L10N37/PSXTAL/PU22+/PU23_Install/PU23_PSXTAL_3F0.png

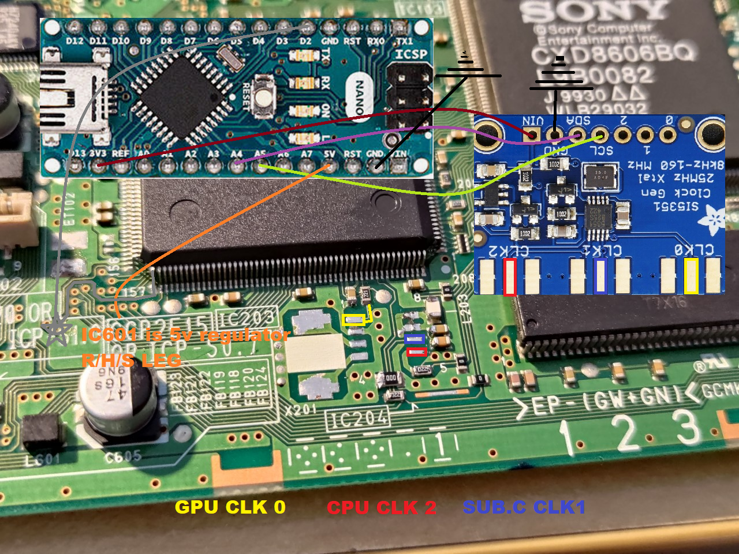
PU22+/PU23_Install/PU23_PSXTAL_3F0.png
