L10N37/PSXTAL/PSXTAL_IGR/ControllerRearWiring.webp

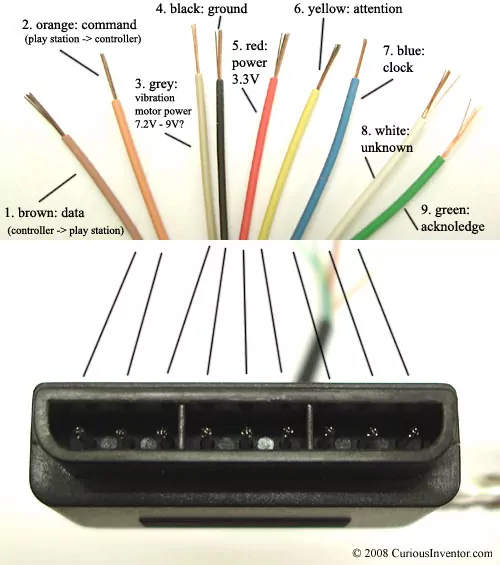
PSXTAL_IGR/ControllerRearWiring.webp
