L10N37/PSXTAL/PSXTAL-DFO/Flashing/FuseSettings.png

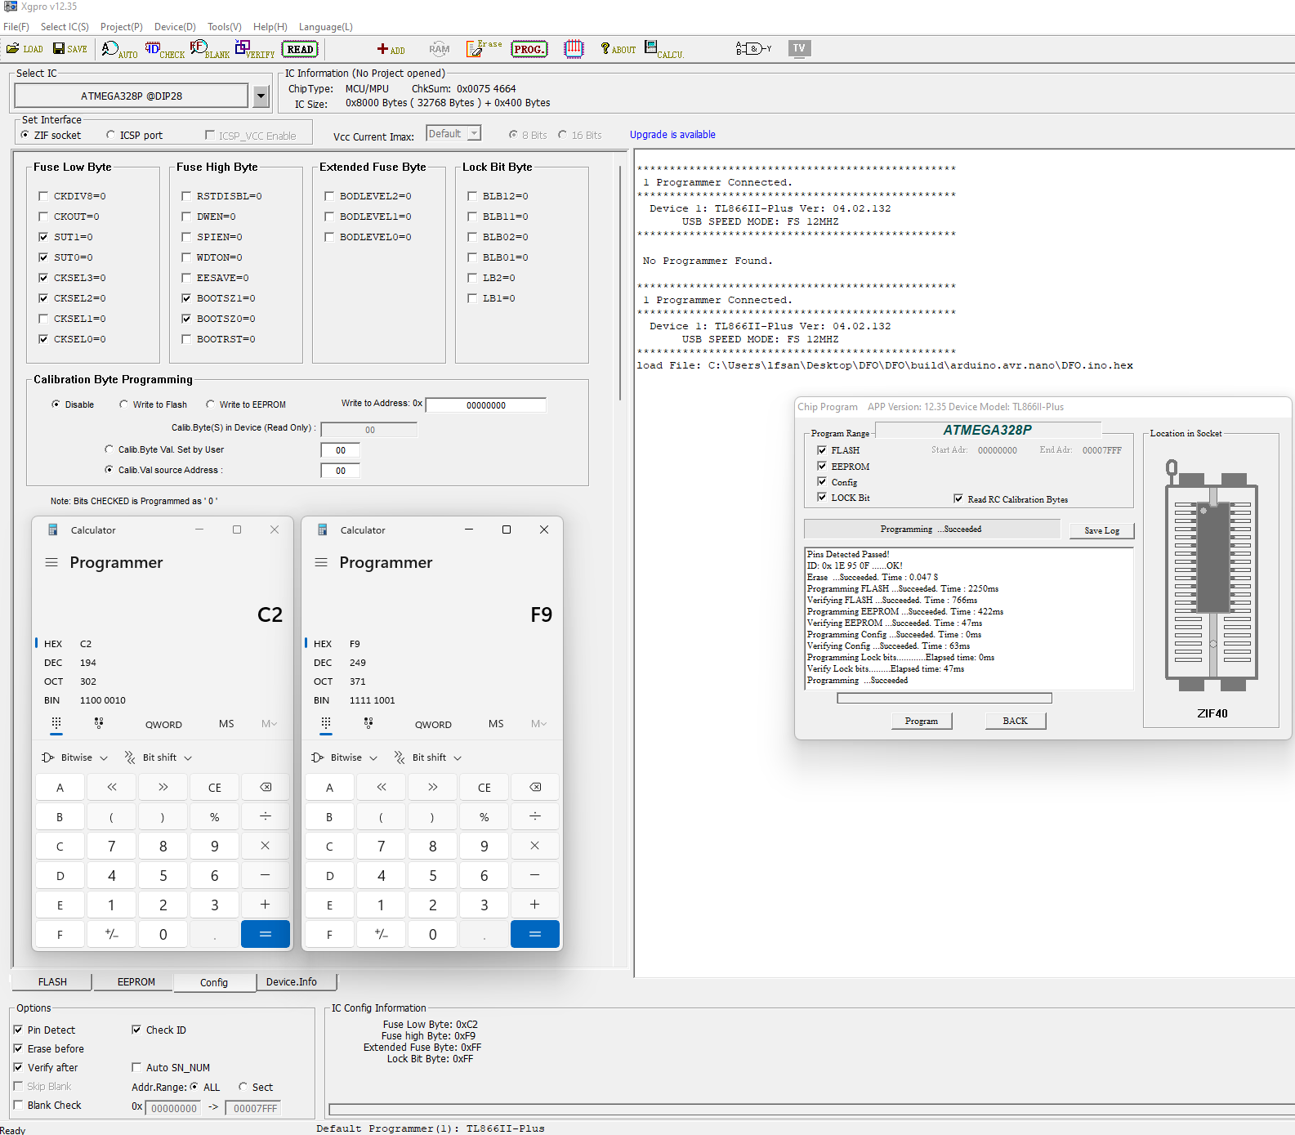
PSXTAL-DFO/Flashing/FuseSettings.png
