L10N37/PSXTAL/PSXTAL-DFO/Flashing/PinOuts-LGT8F-Atmega-328P.png

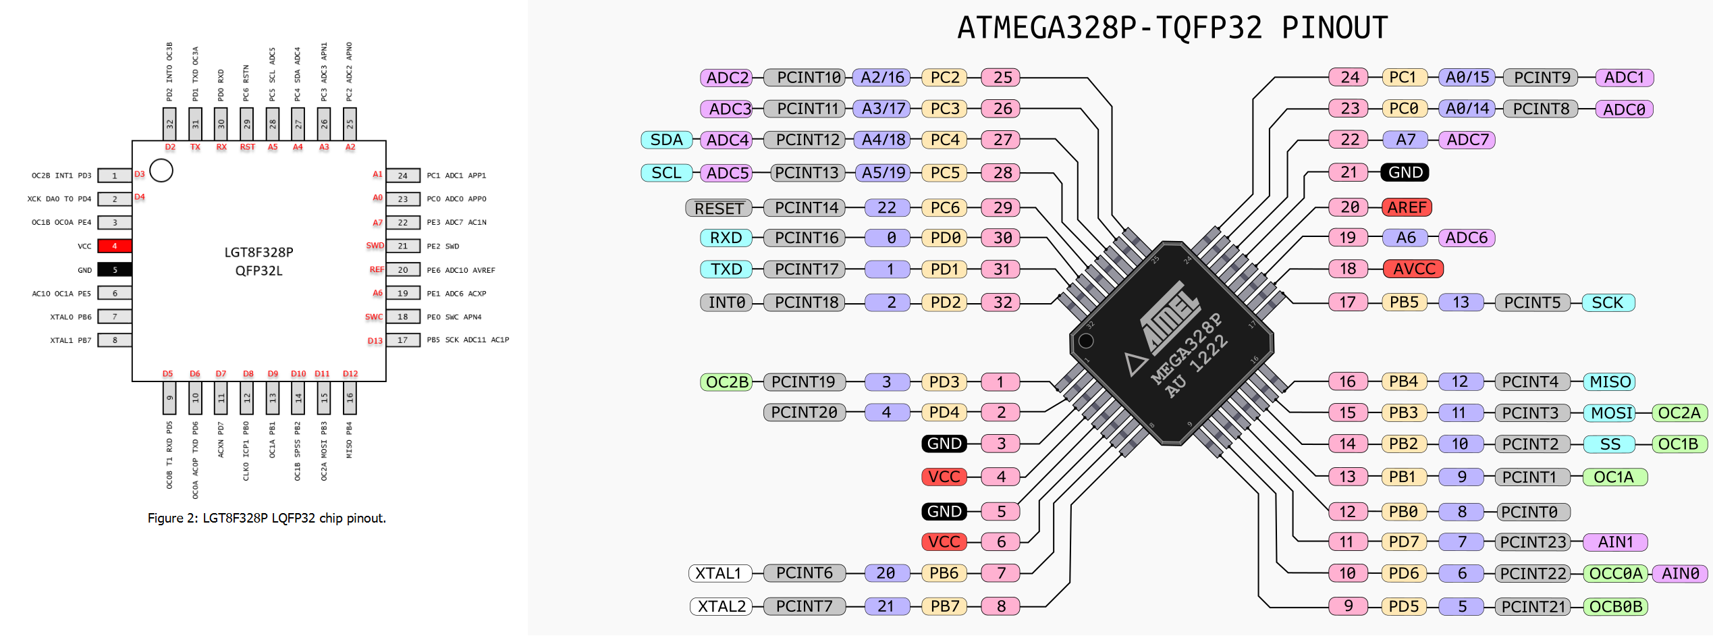
PSXTAL-DFO/Flashing/PinOuts-LGT8F-Atmega-328P.png
