L10N37/PSXTAL/PSXTAL-DFO/Flashing/TQFP32-to-DIP28.png

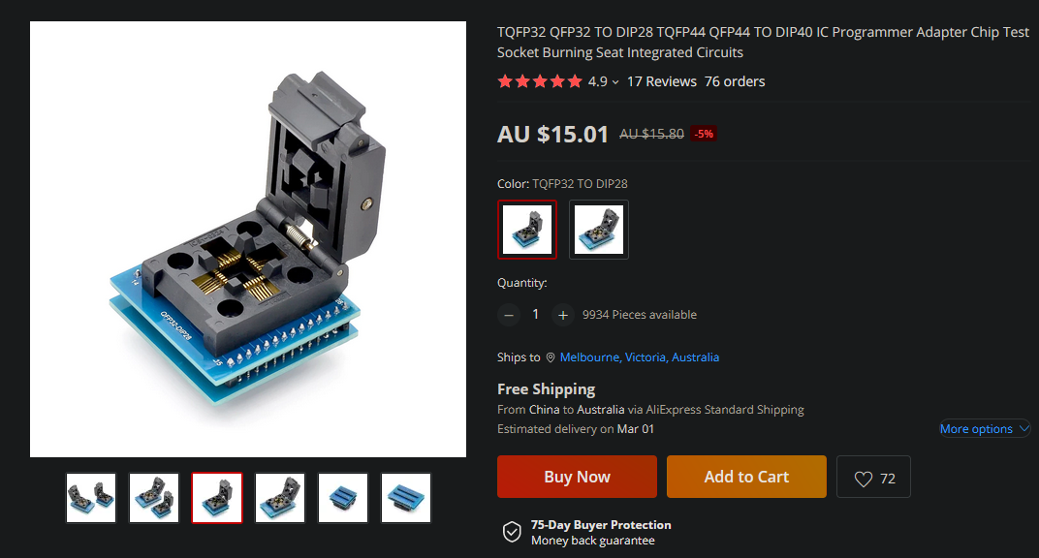
PSXTAL-DFO/Flashing/TQFP32-to-DIP28.png
