L10N37/PSXTAL/PSXTAL-DFO/PCB.png

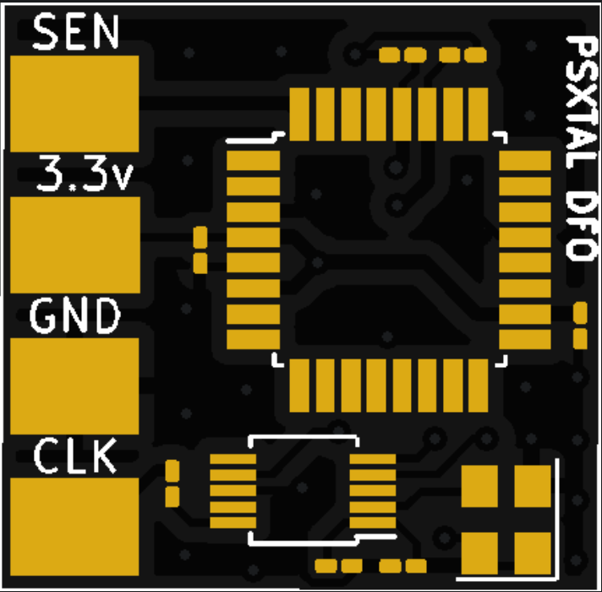
PSXTAL-DFO/PCB.png
