L10N37/PSXTAL/PSXTAL-DFO/PSXTAL_DFO.png

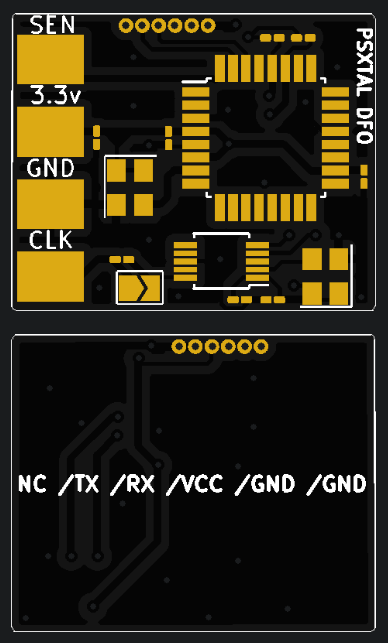
PSXTAL-DFO/PSXTAL_DFO.png
