L10N37/PSXTAL/PSXTAL-DFO/scope/SDS00001.png

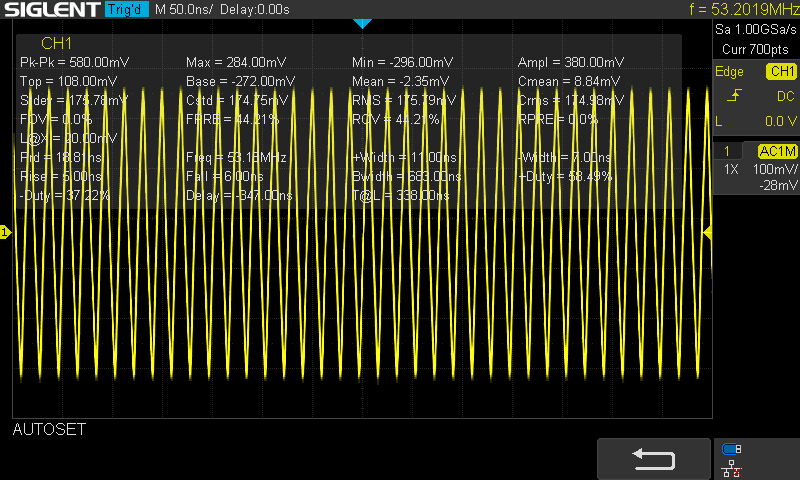
PSXTAL-DFO/scope/SDS00001.png
