L10N37/PSXTAL/PSXTAL-DFO/scope/SDS00002.png

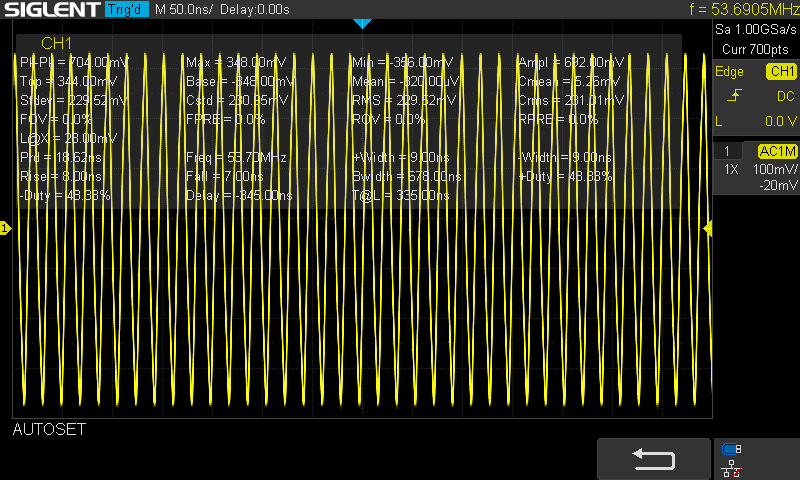
PSXTAL-DFO/scope/SDS00002.png
