L10N37/PSXTAL/PSXTAL-DFO/SI5351Header.png

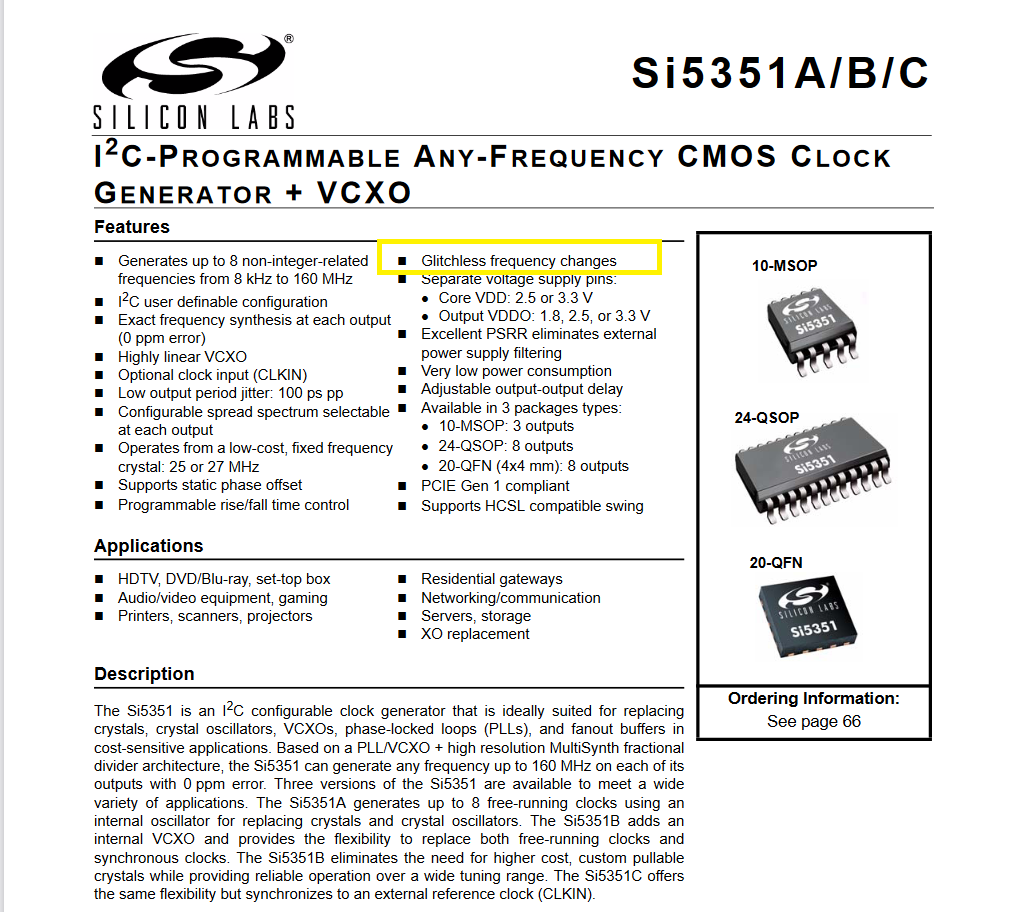
PSXTAL-DFO/SI5351Header.png
