L10N37/PSXTAL/PSXTAL_IGR/P_20210908_150243.jpg

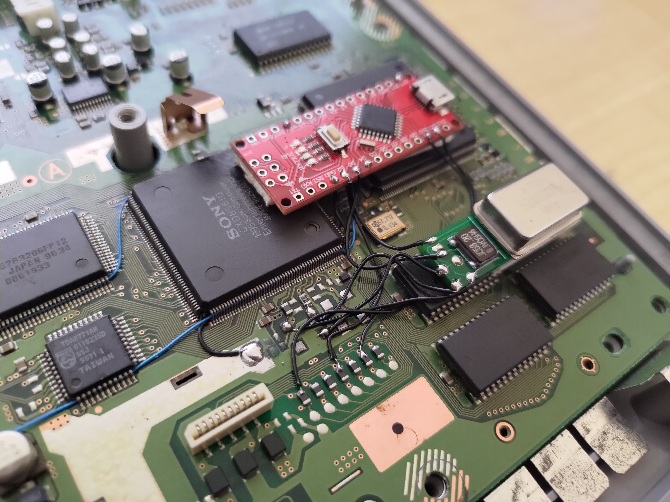
PSXTAL_IGR/P_20210908_150243.jpg
