L10N37/PSXTAL/PSXTAL_IGR/PSXtal PCB Pinout.jpg

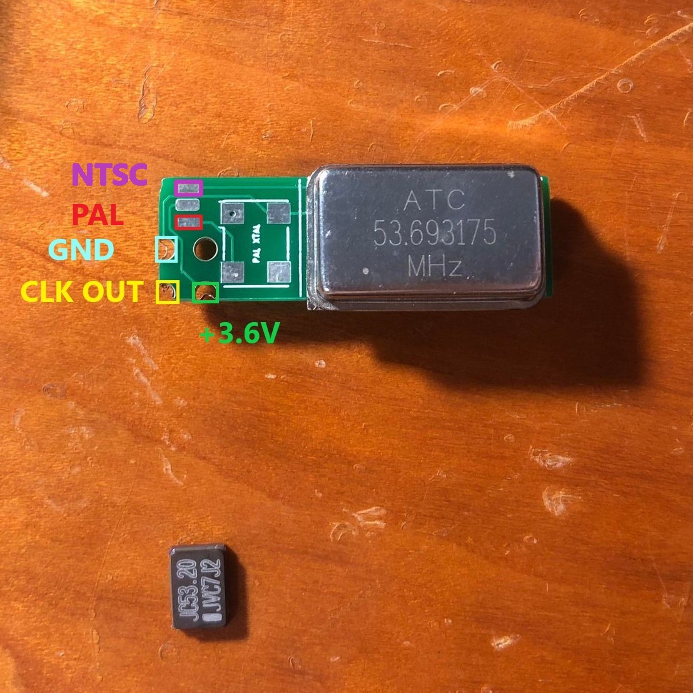
PSXTAL_IGR/PSXtal PCB Pinout.jpg
