L10N37/PSXTAL/PSXTAL_IGR/PSXTAL_V1.00Bx/P_20220501_223348.jpg

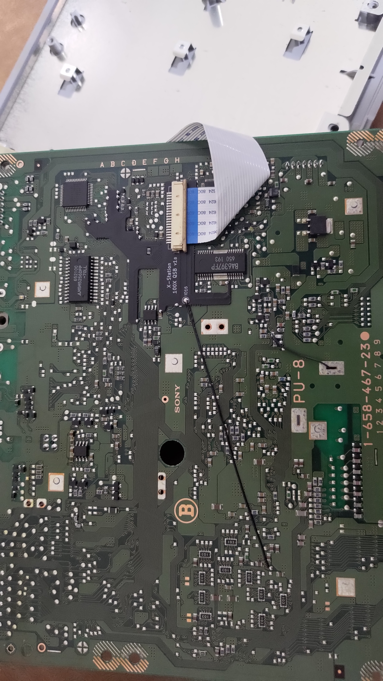
PSXTAL_IGR/PSXTAL_V1.00Bx/P_20220501_223348.jpg
