L10N37/PSXTAL/PSXTAL_IGR/SI5351_Version_Adafruit/PSXTAL_SI5351_R2.png

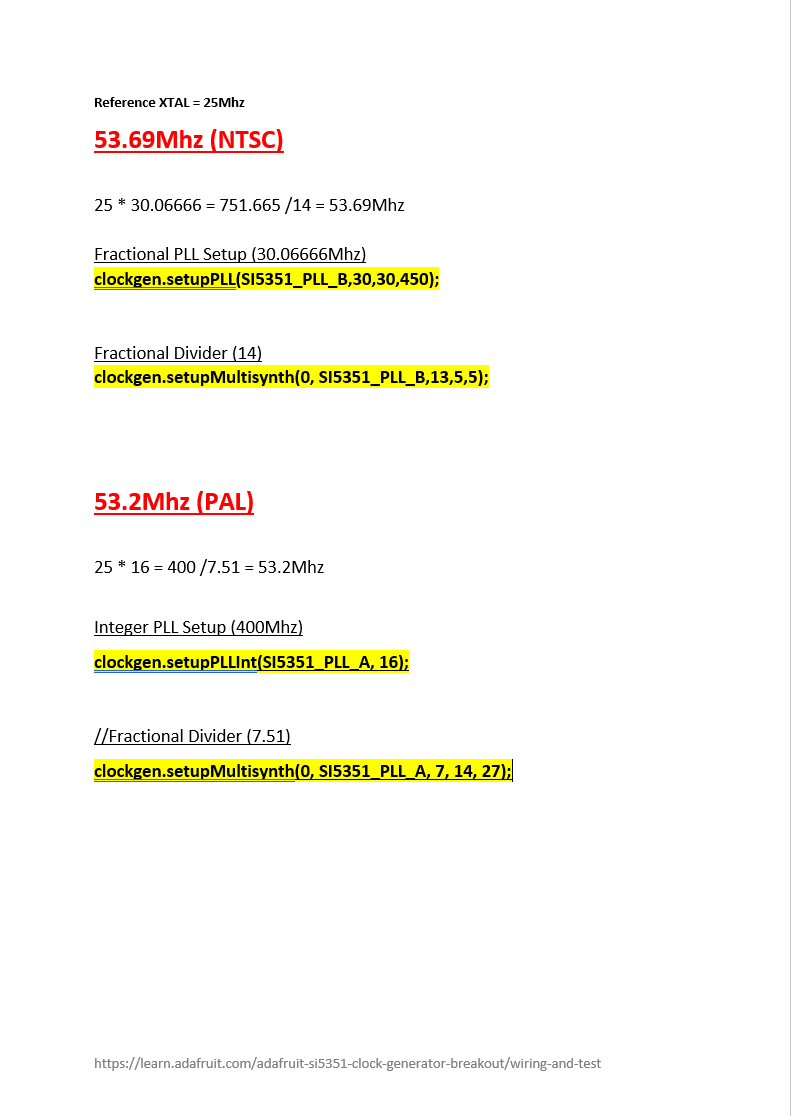
PSXTAL_IGR/SI5351_Version_Adafruit/PSXTAL_SI5351_R2.png
