L10N37/PSXTAL/PSXTAL_IGR/SI5351_Version_Adafruit/SI5351.jpg

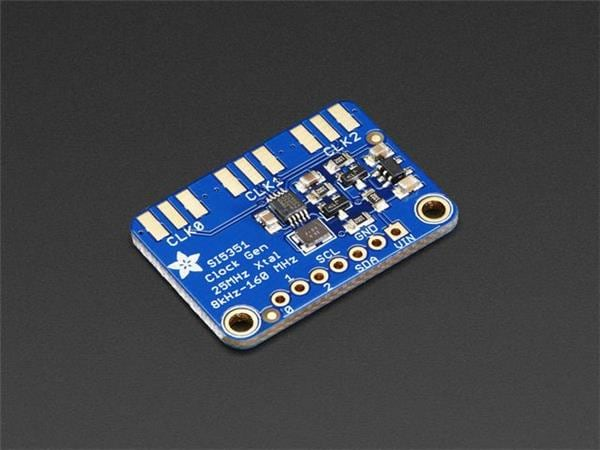
PSXTAL_IGR/SI5351_Version_Adafruit/SI5351.jpg
