L10N37/PSXTAL/PU22+/NTSC/SDS00004.png

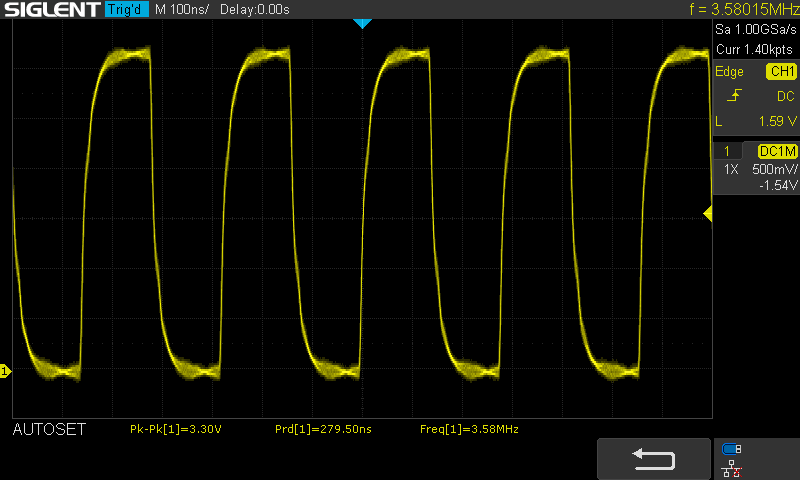
PU22+/NTSC/SDS00004.png
