L10N37/PSXTAL/PU22+/NTSC/SDS00005.png

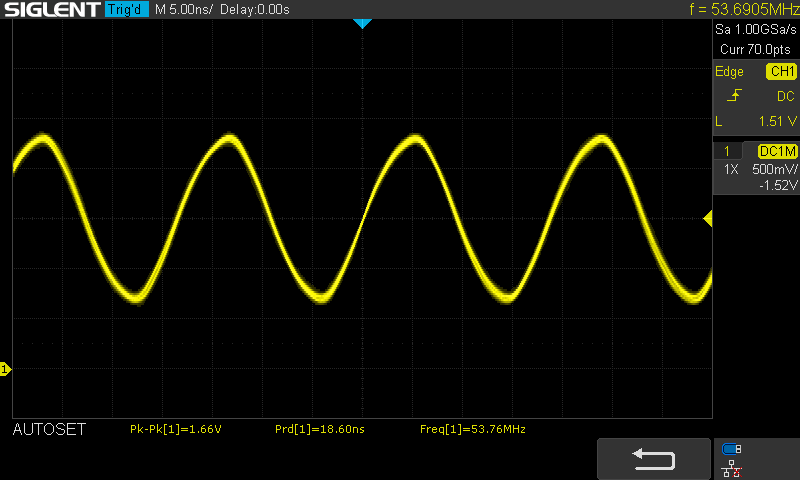
PU22+/NTSC/SDS00005.png
