L10N37/PSXTAL/PU22+/PAL/SDS00003.png

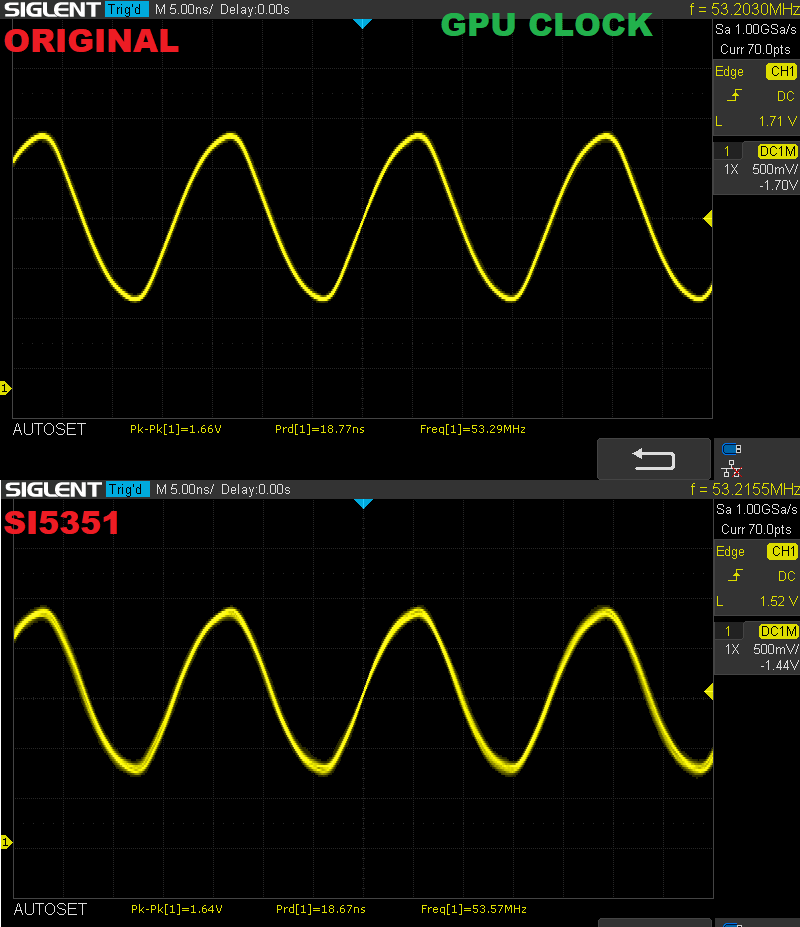
PU22+/PAL/SDS00003.png
