L10N37/PSXTAL/PU22+/PU23ClockGen.png

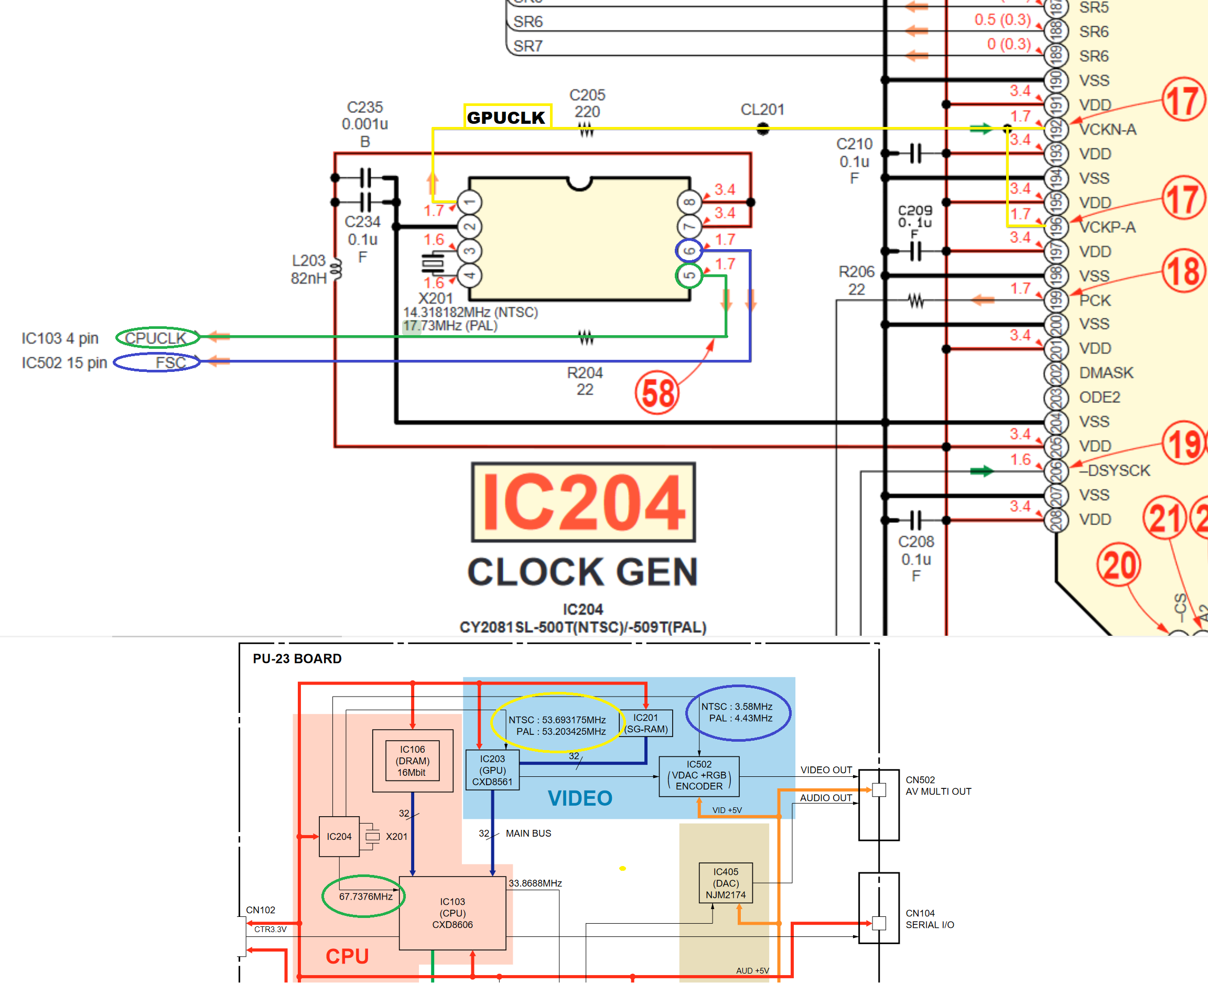
PU22+/PU23ClockGen.png
