L10N37/PSXTAL/Random_foster_cat_photo.jpg

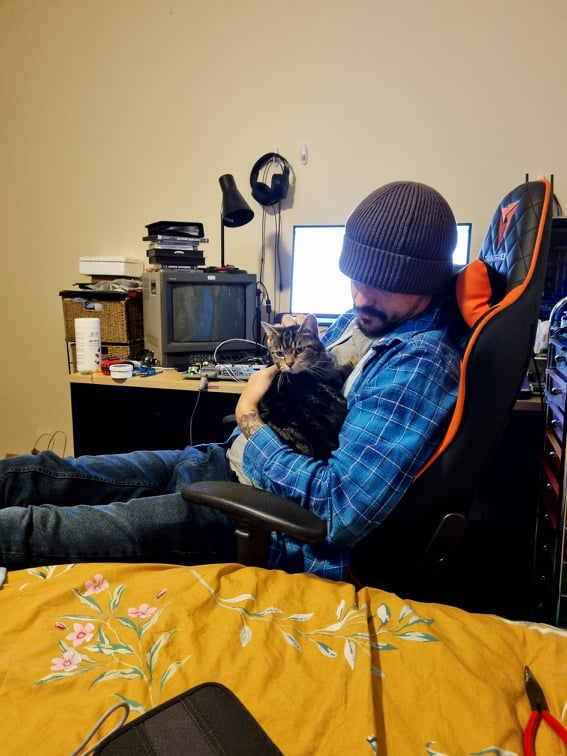
Random_foster_cat_photo.jpg
