L10N37/PSXTAL/Stand-Alone-IGR/P_20230113_033105_1.jpg

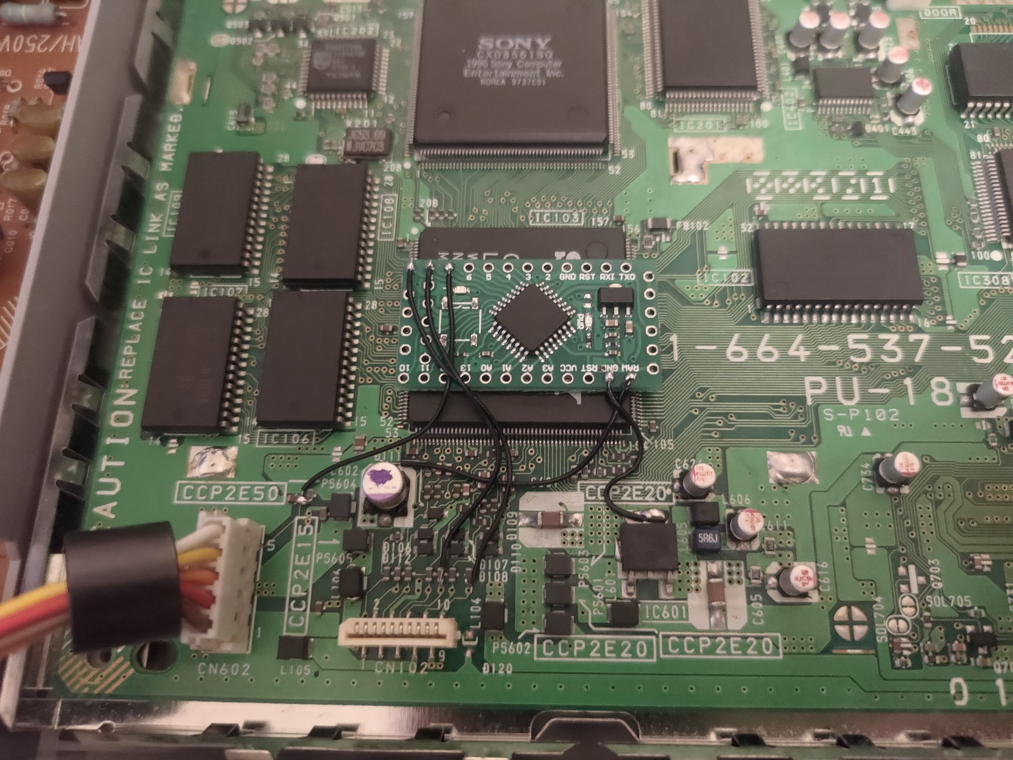
Stand-Alone-IGR/P_20230113_033105_1.jpg
