L10N37/PSXTAL/PSXTAL_IGR/Controller_wiring.png

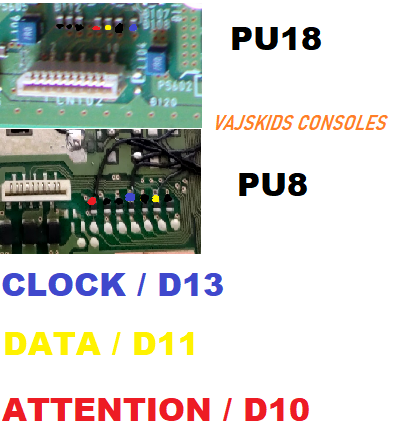
PSXTAL_IGR/Controller_wiring.png
