L10N37/PSXTAL/PSXTAL_IGR/PSXTAL_V1.00Bx/PU-18 Wiring.jpg

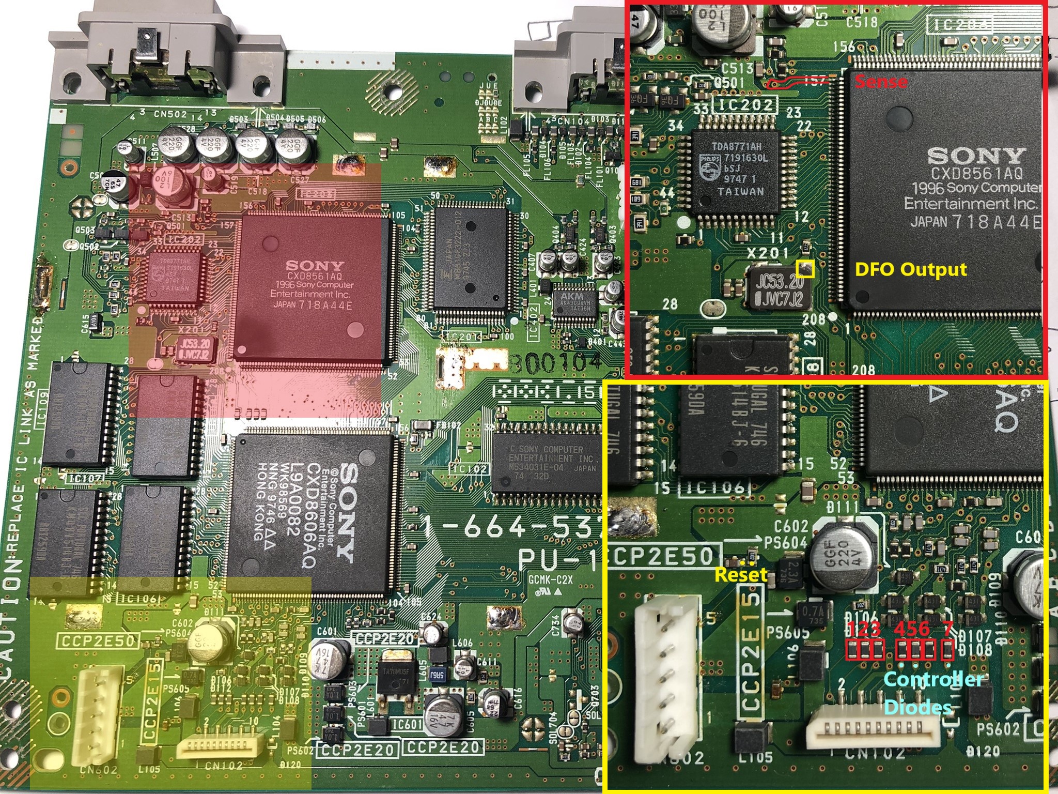
PSXTAL_IGR/PSXTAL_V1.00Bx/PU-18 Wiring.jpg
