L10N37/PSXTAL/(threads)

Thread 1 (2022-03-20):

PSXTAL 3F0

L10N37, 2022-03-20:
On paper the PAL sub carrier clocks @ 4.3310, I get 4.3308 on the scope (slight discrepancy is expected).
I have a new Toshiba Flat Bomba that doesn't like this, Black and white! NTSC games once launched are however fine.

Will investigate further eventually. No other versions affected. Will be dropping the 6 second GPU initialisation  to 5.2 seconds as out of about 30 power ups it did hang once and need a power cycle.

Thread 3 (2022-10-10):

PSXTAL-3FO - Onboard clock decoupling question

TheFellowJasper, 2022-10-10:
Hello, after reading on how to get my PU-22 psx dual-region capable, i've stumbled upon your project and immediately became interested. I have one question however, since I assume its required step, how did you decouple internal console clock? From the install picutre I've seen you've desoldered IC204, but what about the rest? Not exactly sure where to trace other passive elements (as in, to which pins of the gpu are they connected)

TheFellowJasper, 2022-10-10:
Ok, I think I've found pins I need. 196/192 and 199 should be the pins I need to trace signals from, is this correct?

L10N37, 2022-10-17:
Hi there, sorry for the late response.  Just got these emails now.

I left a diagram showing that I removed the entire PLL providing all 3 clocks and replaced them with my project. it shows you where you wire each signal /clock back into the board.

If you only want to get the accurate refresh rate from scalers you don't need to go to this extent and can simply wire in the NTSC Oscillator (large one) onto the VCKN-A pin after separating the trace from the other VCKP-A pin (cut trace or pin lift)

TheFellowJasper, 2023-02-10:
Sorry for ghosting my own issue, life things and all that

Just wanted to report that your mod seems to be working well on my PSX, big thanks for making this mod :)

L10N37, 2023-02-10:
No worries :)
I'm in the process of making a stand-alone one on a custom PCB starting with just the GPU clock, but I haven't got much spare time lately.
Trying to get it working without an external XTAL (for the MCU) is where it's at..

Thanks for the feedback :)

Get Outlook for Android<https://aka.ms/AAb9ysg>
________________________________
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

Closed 2023-01-19.

Thread 5 (2023-01-19):

Stand-Alone IGR - IGR Combos don't work in 'The X-files' when using BlueRetro

L10N37, 2023-01-19:
Confirmed to only affect my BlueRetro dongles with my 8Bit Do Pro2 controllers

Working with wired controllers.

Probably not going to look into this one.

Only game I've encountered that wouldn't work with the same set up.

L10N37, 2023-01-19:
Analogue mode broken - tested before finalising and analogue mode needs one less constant byte to be present to trigger reset.
Very weird.

Disabling analogue mode gives you back your reset combos.

Will fix it eventually.

L10N37, 2023-01-21:
Fixed

Closed 2023-01-21.
