L10N37/PSXTAL/(commit log)

2021-09-05 Create psXtal_IGR.ino
    Switches wirelessly between an NTSC and PAL XTAL for true 50/ 60Hz + in game reset with short and long pulse :) for Sony Playstation 1
2021-09-06 Update psXtal_IGR.ino
    // Based off an EXTREMELY modified version of GolamMostafas code @ [https://forum.arduino.cc/t/spi-slave-mode-example-code/66617/4]
    // This was the giant kick starter to get things going, it intercepted and read inputs straight away! Google really done it's job, Cheers Golam!
    // Arduino wires currently soldered direct to the rear of the controller / memory card port (clock = D13, data = D11, attention = D10)
    // 5v to arduino (nothings ever taken 'high' bar the XTALs) with 220uf bypass cap.
    // Made for my dual Xtal PCB's, arduino routes power to either crystal, switching video modes wirelessly.
    //===============================================================/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
2022-01-28 Add files via upload
    example installation. The clock/data/ATT lines are wired direct to rear of the controller board here (hidden in heat shrink in the gap) across to the Arduino
2022-07-03 Diagram-ish image for wiring
2022-07-03 Create PU-18 Wiring
2023-05-20 new PCB image
